NaohiroIIDA/MiniKawa_B_pad/3d/mk5_Wheel.3mf

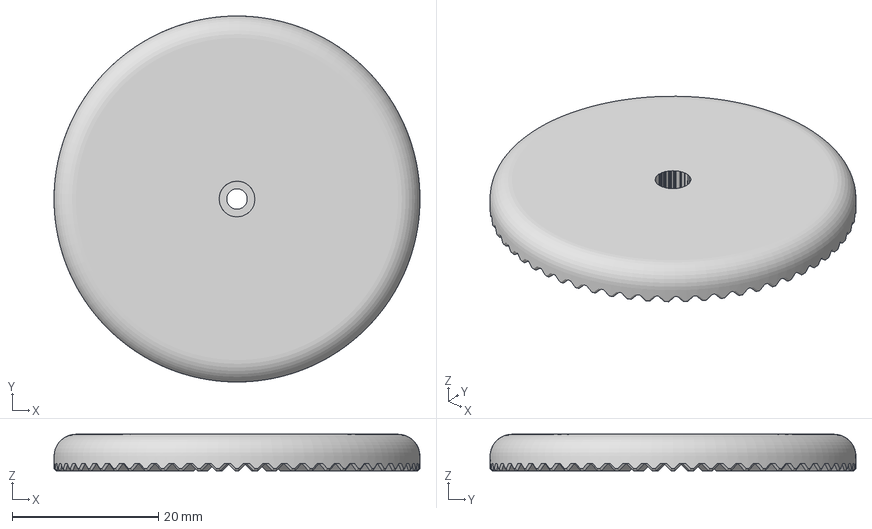
[picture p4: CAD file, 2026-10-17]
3d/mk5_Wheel.3mf
50.0 x 50.0 x 5.00 mm
