NaohiroIIDA/MiniKawa_B_pad/3d/Mk5_Frame.3mf

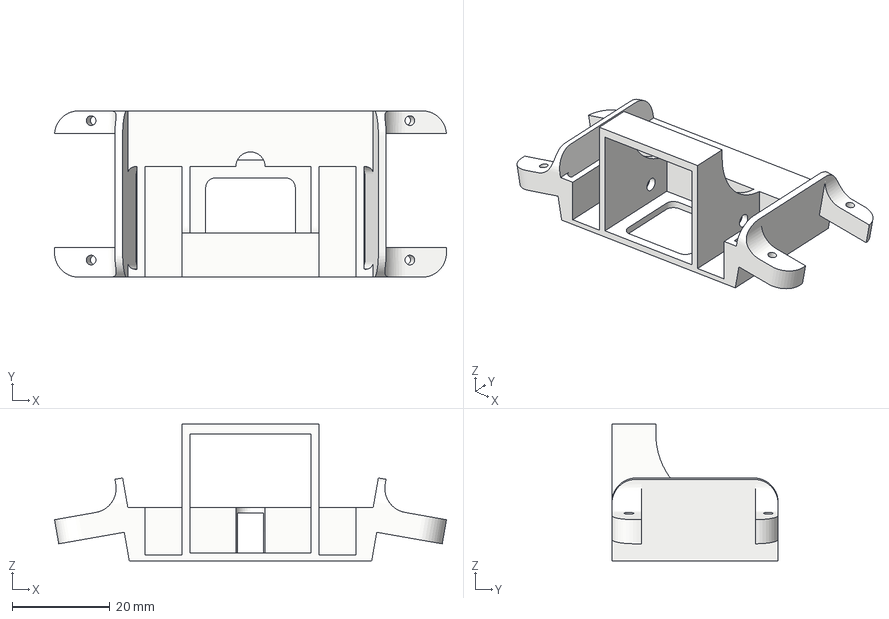
[picture p5: CAD file, 2026-10-17]
3d/Mk5_Frame.3mf
80.1 x 34.0 x 27.9 mm
