NaohiroIIDA/MiniKawa_B_pad/(list of files, cad)

Other CAD files:
3d/MiniKawa_Mk5.f3z
