NaohiroIIDA/MiniKawa_B_pad/(commit log)

2026-10-17 M5Atom Lite Bluetooth ゲームパッド操縦ロボット
    - Bluepad32 によるゲームパッド操縦と連続回転サーボの差動駆動
    - サーボ信号ピンを実体配線図に合わせて G21 (左) / G25 (右) に変更
    - README に完成写真・実体配線図・組み立て手順・10440 電池と USB-C の注意事項を追加
2026-10-17 3Dプリント部品のデータを追加
    - 3d/ にフレーム・ホイールの 3MF と Fusion 360 設計データ (.f3z) を追加
    - README に部品一覧 (必要数・寸法) と印刷手順を追記
    - .DS_Store を無視
2026-10-17 README に CAD 外観図を追加
2026-10-17 README にハの字車輪 (ロッキングチェア方式) の説明を追加
2026-10-17 README から電池の配置位置の記述を削除
2026-10-17 README を英語化し、日本語版を README.ja.md に分離
2026-10-17 ソースコードのコメントを英語化
2026-10-17 README のタイトルをリポジトリ名 MiniKawa_B_pad に変更
2026-10-17 Update README.md（add movie)
2026-10-17 日本語版 README にも走行動画を追加
